MrAlvin/RAMPS_1.7/Schematics/images/1.7B3-top-aux.jpg

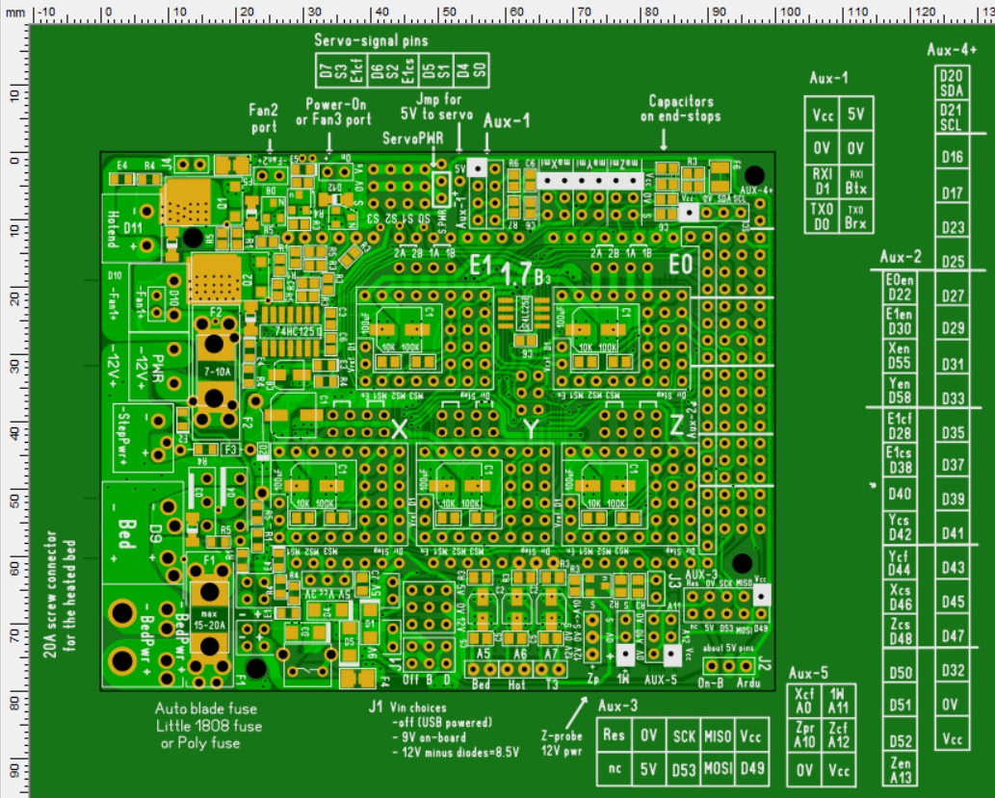
Schematics/images/1.7B3-top-aux.jpg
