MrAlvin/RAMPS_1.7/Schematics/pictures/extra_5V_on-board-power-800px.jpg

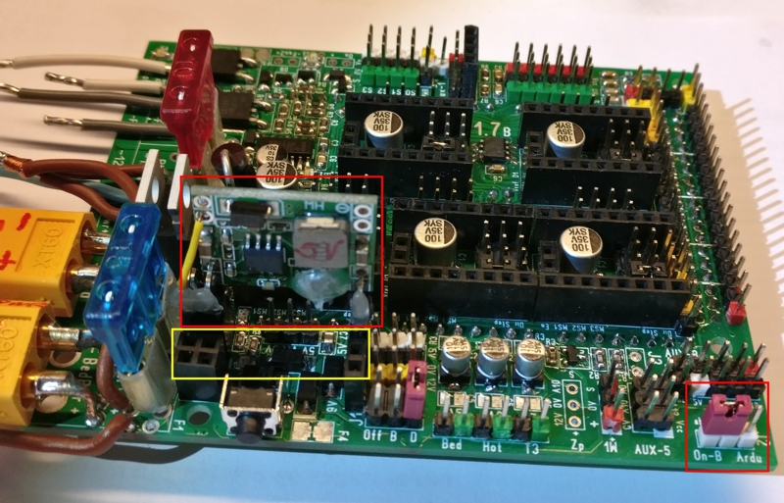
Schematics/pictures/extra_5V_on-board-power-800px.jpg
