MrAlvin/RAMPS_1.7/README.md

# RAMPS_1.7
An Arduino Shield for 3D printers

Documentation at: https://reprap.org/wiki/RAMPS_1.7<br>
Forum discussion at: https://reprap.org/forum/read.php?219,824661<br>
Firmware development at: https://github.com/MrAlvinTesting/Marlin/tree/bgfx-20x-R17-dev
