MrAlvin/RAMPS_1.7/Schematics/images/1.7B3-top-12V-options.jpg

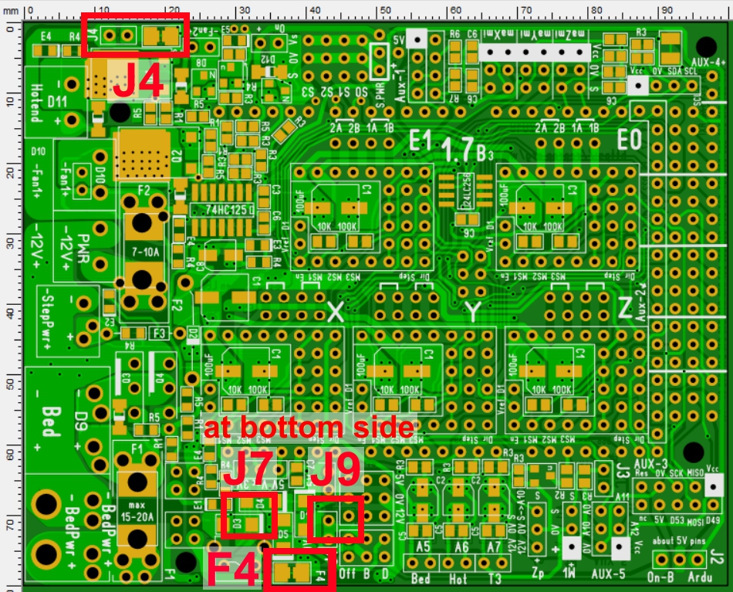
Schematics/images/1.7B3-top-12V-options.jpg
