MrAlvin/RAMPS_1.7/Schematics/images/1.7B3-top_extra_5V_on-board-power.jpg

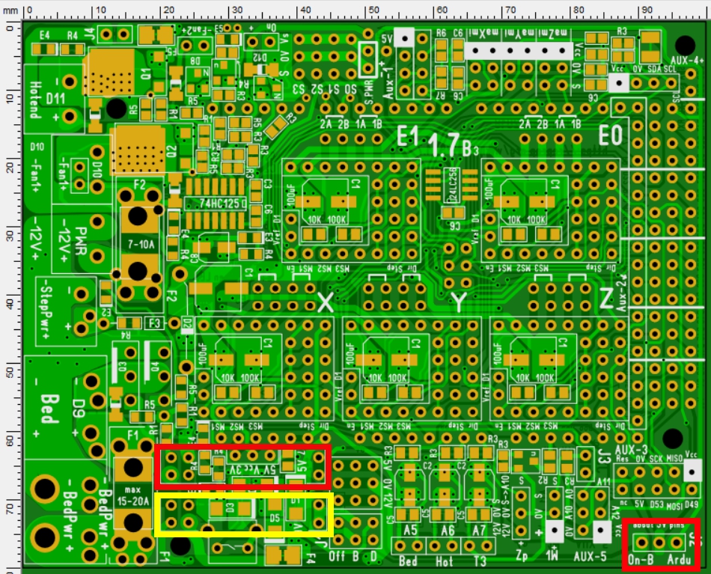
Schematics/images/1.7B3-top_extra_5V_on-board-power.jpg
