MrAlvin/RAMPS_1.7/Schematics/images/12V+5V-rails.jpg

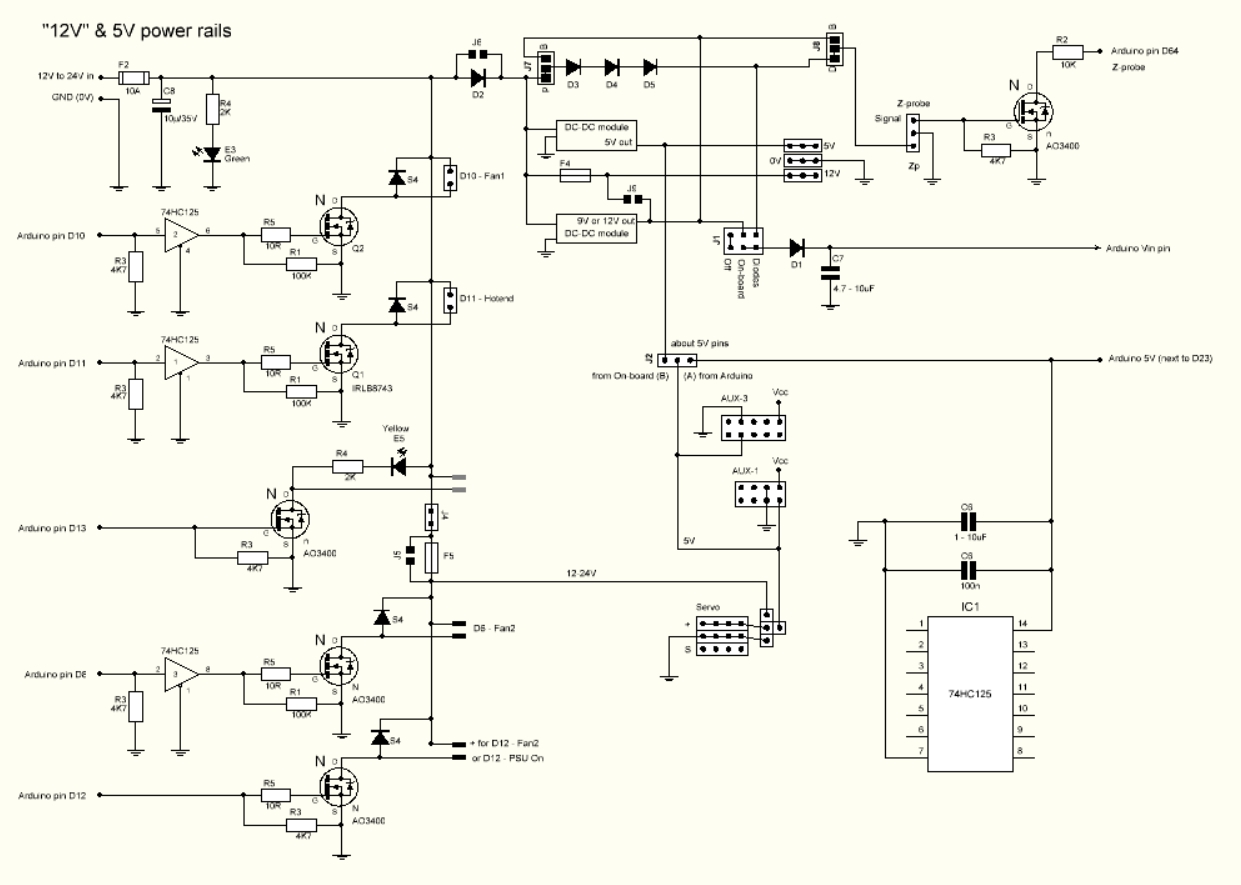
Schematics/images/12V+5V-rails.jpg
