MrAlvin/RAMPS_1.7/Schematics/images/extra_5V_on-board-power.jpg

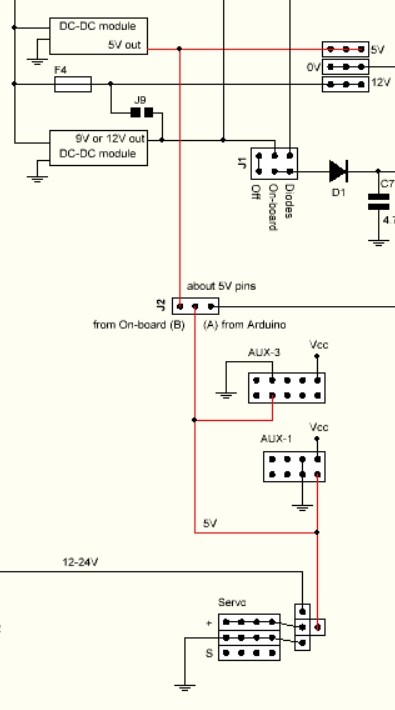
Schematics/images/extra_5V_on-board-power.jpg
