MrAlvin/RAMPS_1.7/Schematics/images/Heated_bed.jpg

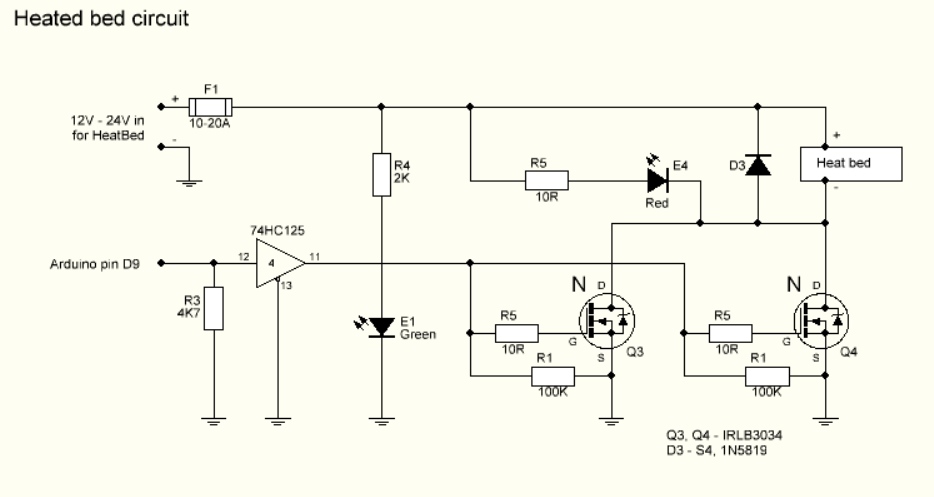
Schematics/images/Heated_bed.jpg
