MrAlvin/RAMPS_1.7/Schematics/pictures/mp1584_dc-dc_regulator.jpg

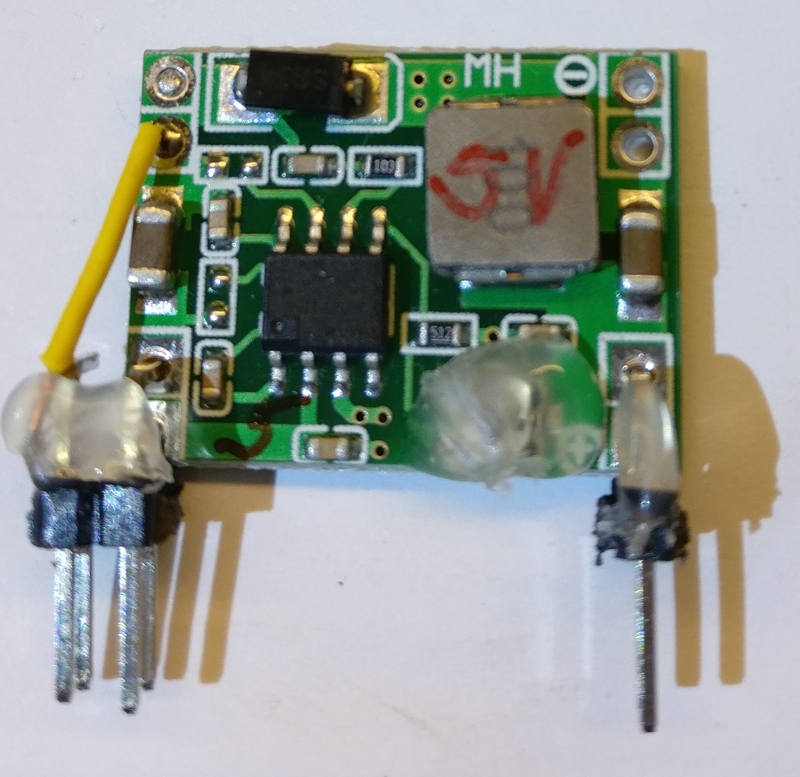
Schematics/pictures/mp1584_dc-dc_regulator.jpg
