MrAlvin/RAMPS_1.7/Schematics/images/24V operation with 12V options.jpg

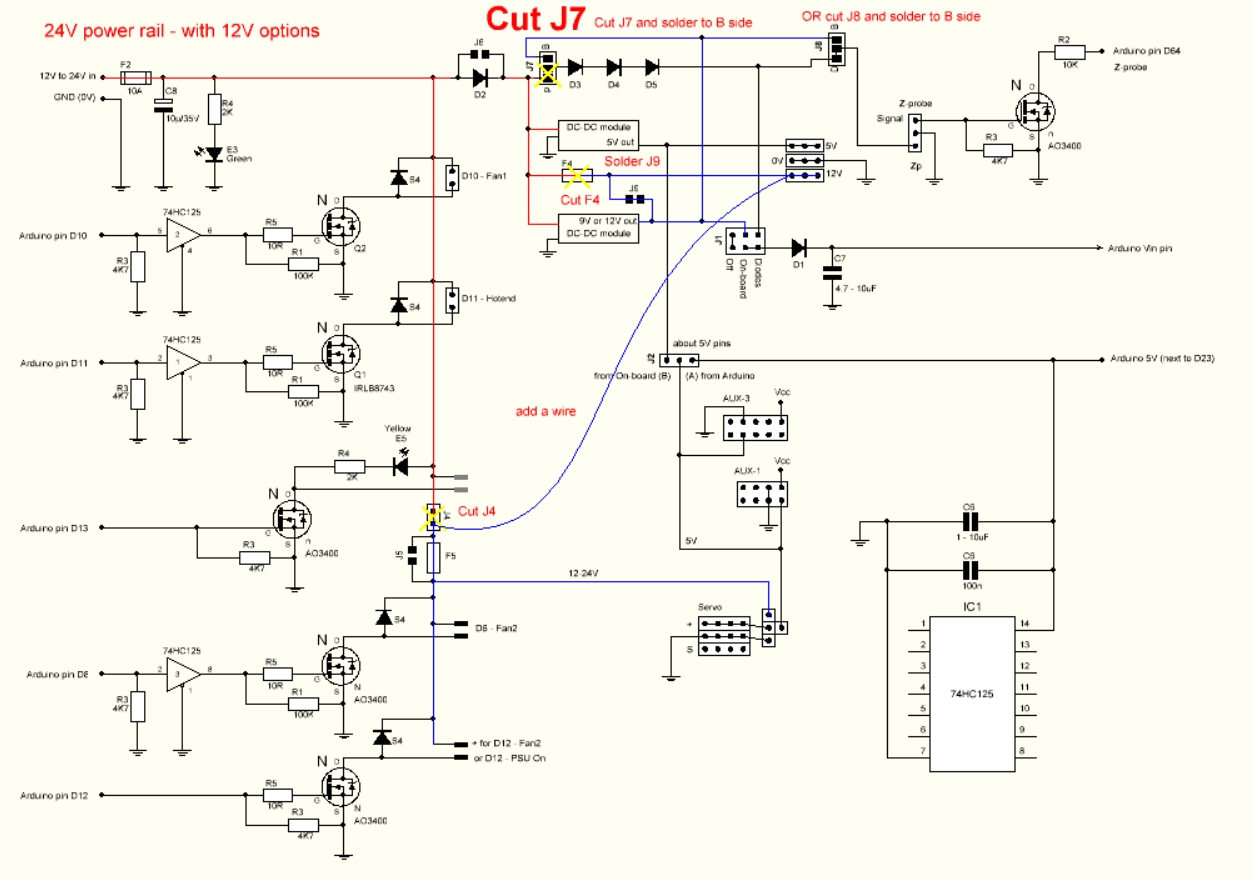
Schematics/images/24V operation with 12V options.jpg
