MrAlvin/RAMPS_1.7/Schematics/images/24V operation.jpg

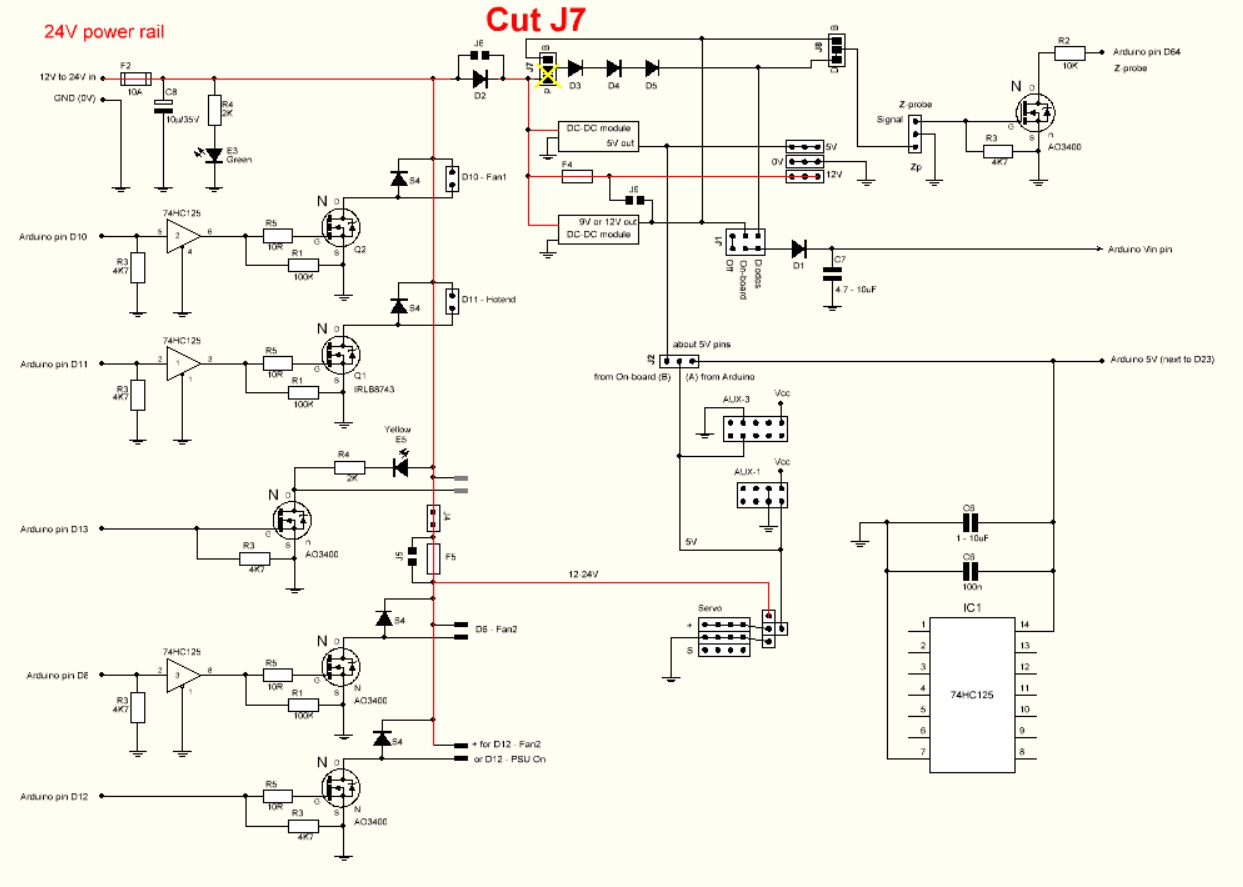
Schematics/images/24V operation.jpg
