MrAlvin/RAMPS_1.7/(threads)

Thread 1 (2018-09-16):

DXF files?

npgoalkeeper, 2018-09-16:
I really want to make another version of this with integrated TMC2130's and multiple TMC4361A's with an SPI encoder input for closed loop stepping.

MrAlvin, 2018-09-16:
Okay. What is an TMC4361A?  And how would it be connected to this Arduino Shield?

npgoalkeeper, 2018-09-16:
I want a DXF file so I have an outline to work with to make this shield, and the program I use you can only import .svg or .dxf files for board outlines and footprints.. The shield will also feature an LCD connector. Technically, the IC can be used to retrofit any motor driver, so the board should still be compatible with the DRV8825's and the A4988 and any other 3.3V or 5V driver.

MrAlvin, 2018-09-17:
I see. That does indeed sound very interesting. Unfortunately the program I work with, can only export gerber files or pictures.
Using a picture, was the way I moved from the RAMPS 1.4 design, to this RAMPS 1.7 design, as I am using a different PCB design program.

npgoalkeeper, 2018-09-17:
Alright. I'll figure it out :) I'll just wait until the final version is released in order to make my shield. Thanks.

MrAlvin, 2018-09-18:
hmmm.... good question.

The max size is 100 x 100 mm, and on one side, this max was reached on day one. And it seems that from time to time, I add a few millimeters, to accommodate the latest discovery/needed-adjustment/better design-idea.

I would like to re-design the entire mosfet area, as there are a few components that are with a rather tight fit.  But this would be a lot of work, so for now, I just leave it be.

 Either way; so far I seem to have made small adjustments about every week or so.

The four main influences to cause adjustments have so far been:

- because things look good on paper, does not mean that it feels right when you have the thing in your hands ..... and need to plug stuff in.  There may be room on paper, but it would simply be more smooth if this or that small adjustment was made.

- a design decision, made when things were first designed, may turn out to be better, if adjusted slightly, when I give it a second or third overhaul, or look deeper into details.

- making the Marlin firmware work.  As I have needed to dig in deeper under the hood of Marlin, I discover new things.
Like, this week, I have for instance made adjustments so it would be much easier to also use the shield with the Re-ARM MCU board.

- I have been working on adding functionality to the LCD board. Mainly so the entire LCD and buttons section can be controlled via I2C or SPI I/O-expanders. But this work has spun up more ideas, like;
-- what if  an ESP-01 connector could be added to the main board?
-- and what if temperature sensors could be made to be able to handle volt abuse, like; 24V applied to either of the two wires to the temperature sensor to have no effect of the MCU. That would be a rather nice addition.
--servo pin 3 and 4 have dual functionality. What if the re-arranging of the mosfet-section, also caused there to be room for easy jumper connectors to move some functionality to freed pins on aux-4, now that the LCD is being handled by I/O-expanders.
-- what if I/O-expanders, especially SPI I/O-expanders were added to some of the fewer-pin-count 32-bit processors, would it then be possible to use 4-5 dollar MCU's to control the board. And would this cause me want to make adjustments to the RAMPS 1.7 board?
-- what if a universal I/O-expander, like an atmega88, were added to the mix, would it then be feasible to monitor voltages and fuses?

Yes, stuff like that seems to creep in, and cause the board to sometimes grow a little, in the one direction where there is still room to grow.

What is however set in stone, is:
- the Arduino pins layout.
- the correlation of placement between Aux-3 and Aux-4.  The most common LCD adapter, uses both these ports, and it MUST be possible to use that adapter board with a RAMPS-named board.
- the stepper drivers are not going to move....... Unless - the mosfet-section gets a makeover. As it would be nice to move the X,Y,Z stepper section about 1mm away from the Aux-2 / Aux-4 section.

So, does this answer you question?

Are there any particular connectors that you are more interested in, to not move?

npgoalkeeper, 2018-09-18:
No. That's it. Thanks. I'd rather this shield not change and mine to change a LOT so that you're not restricted. If you had to accommodate for everybody, then nothing would get done. I'll start doing BOM, then I'll do PCB design later down the line when you have the final layout. If you do change the layout in the future after I made my shield, then I'll change the layout of mine. I really do believe in the philosophy of a modular system with bits that can be changed. I got so triggered when apple started soldering their RAM and SSD's straight to the board.

npgoalkeeper, 2018-09-18:
Oh btw the free (so professional) program that I use is cloud based, and you can oversee my project if you so desire:
here:https://easyeda.com/npgoalkeeper/ramps1-7
It will feature an LCD connector, the stuff I said earlier, but no connector for stepsticks, I want to be able to use dcstep which has has an output that is not broken out. Also, no current scaling via potentiometer,  only through firmware via PWM (I'm using a DAC, digipot is too expensive).

Also, I won't  close this issue. I clearly keep changing my mind.

npgoalkeeper, 2018-09-19:
For the regulator, should I add a Ti PMIC along with a flyback converter controller and n-ch mosfets? The output would be able to change from 5v to 3.3v with a very small tolerance (around 3 percent of I recall correctly). Otherwise, I will just stick with the lm2576 linear regulator.
