MrAlvin/RAMPS_1.7/Schematics/pdf/RAMPS_1.7_24V-operation.pdf

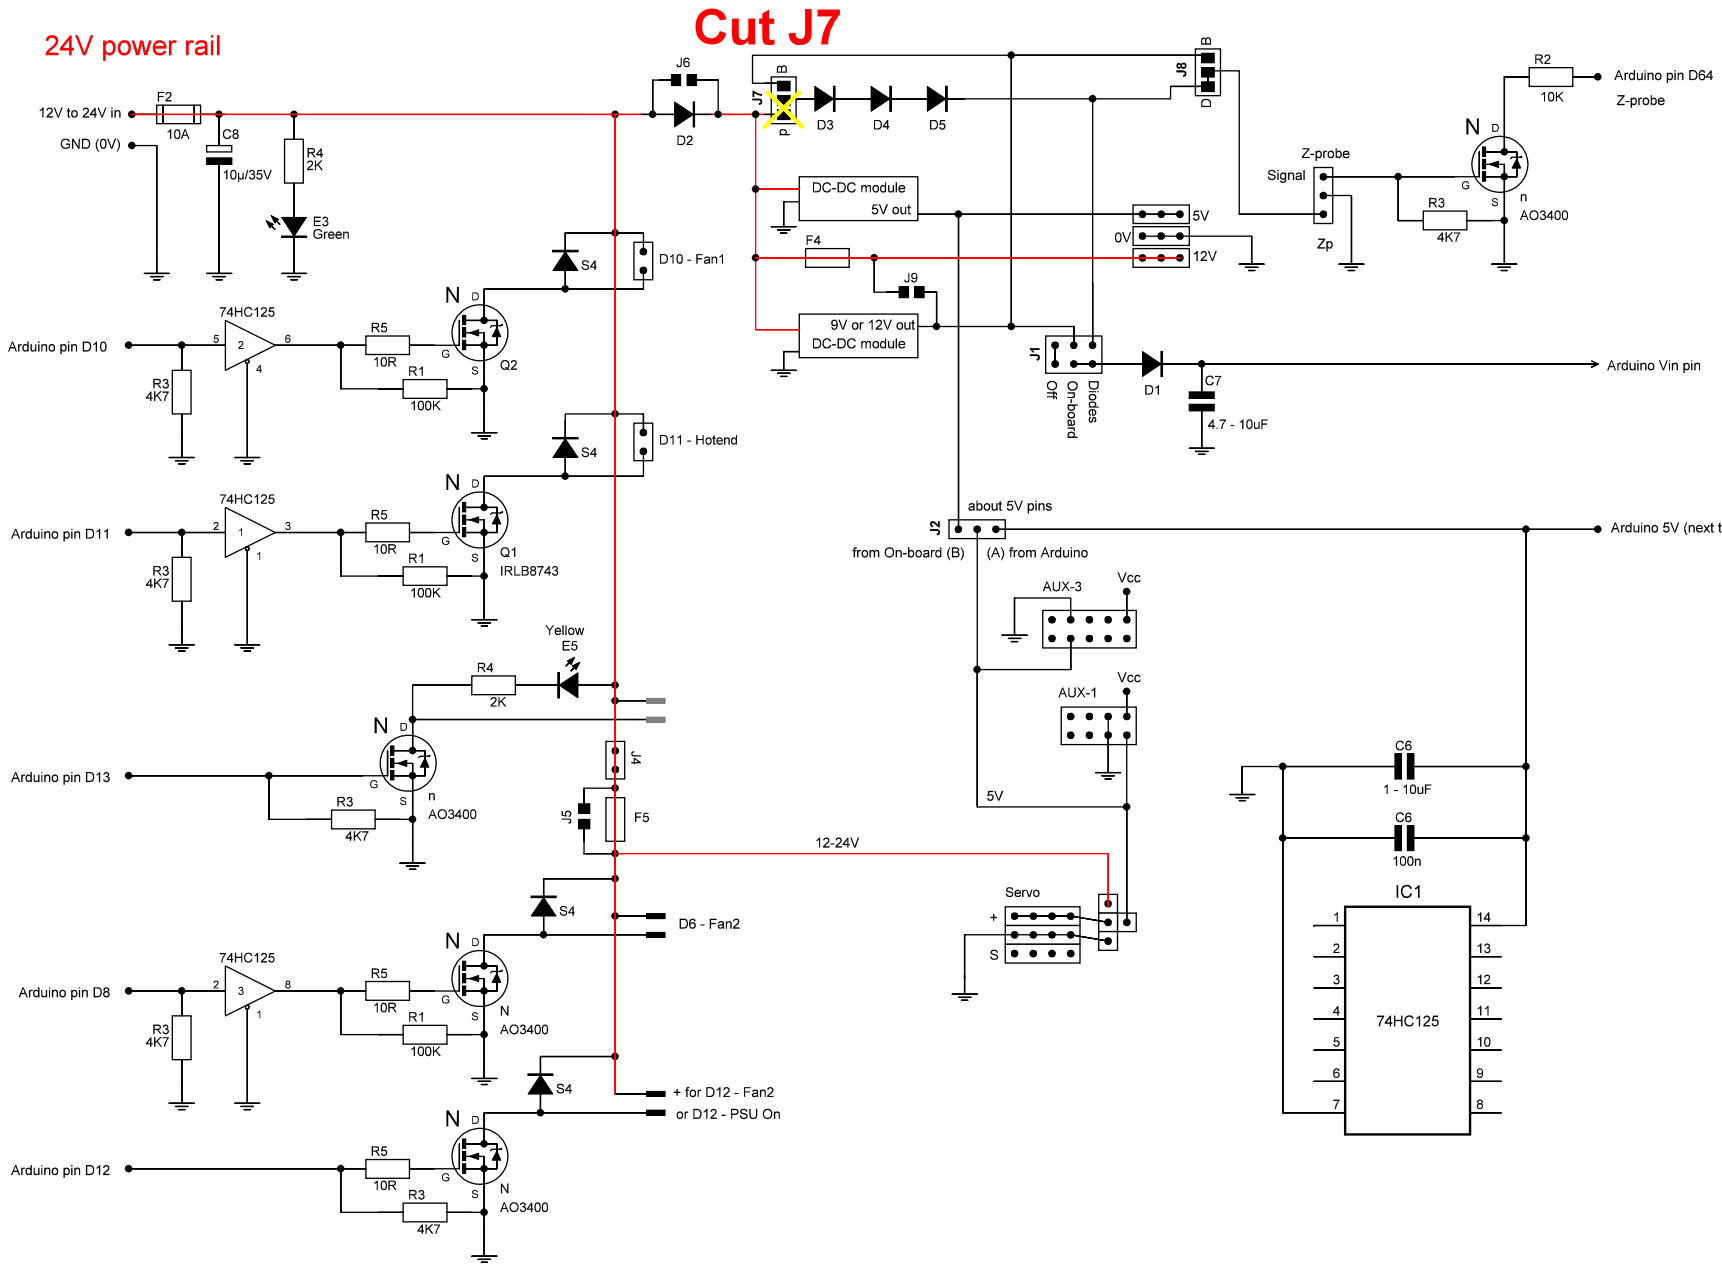
[picture p11: page 1]
