MrAlvin/RAMPS_1.7/Schematics/pdf/RAMPS_1.7_24V-operation_with-12V-options.pdf

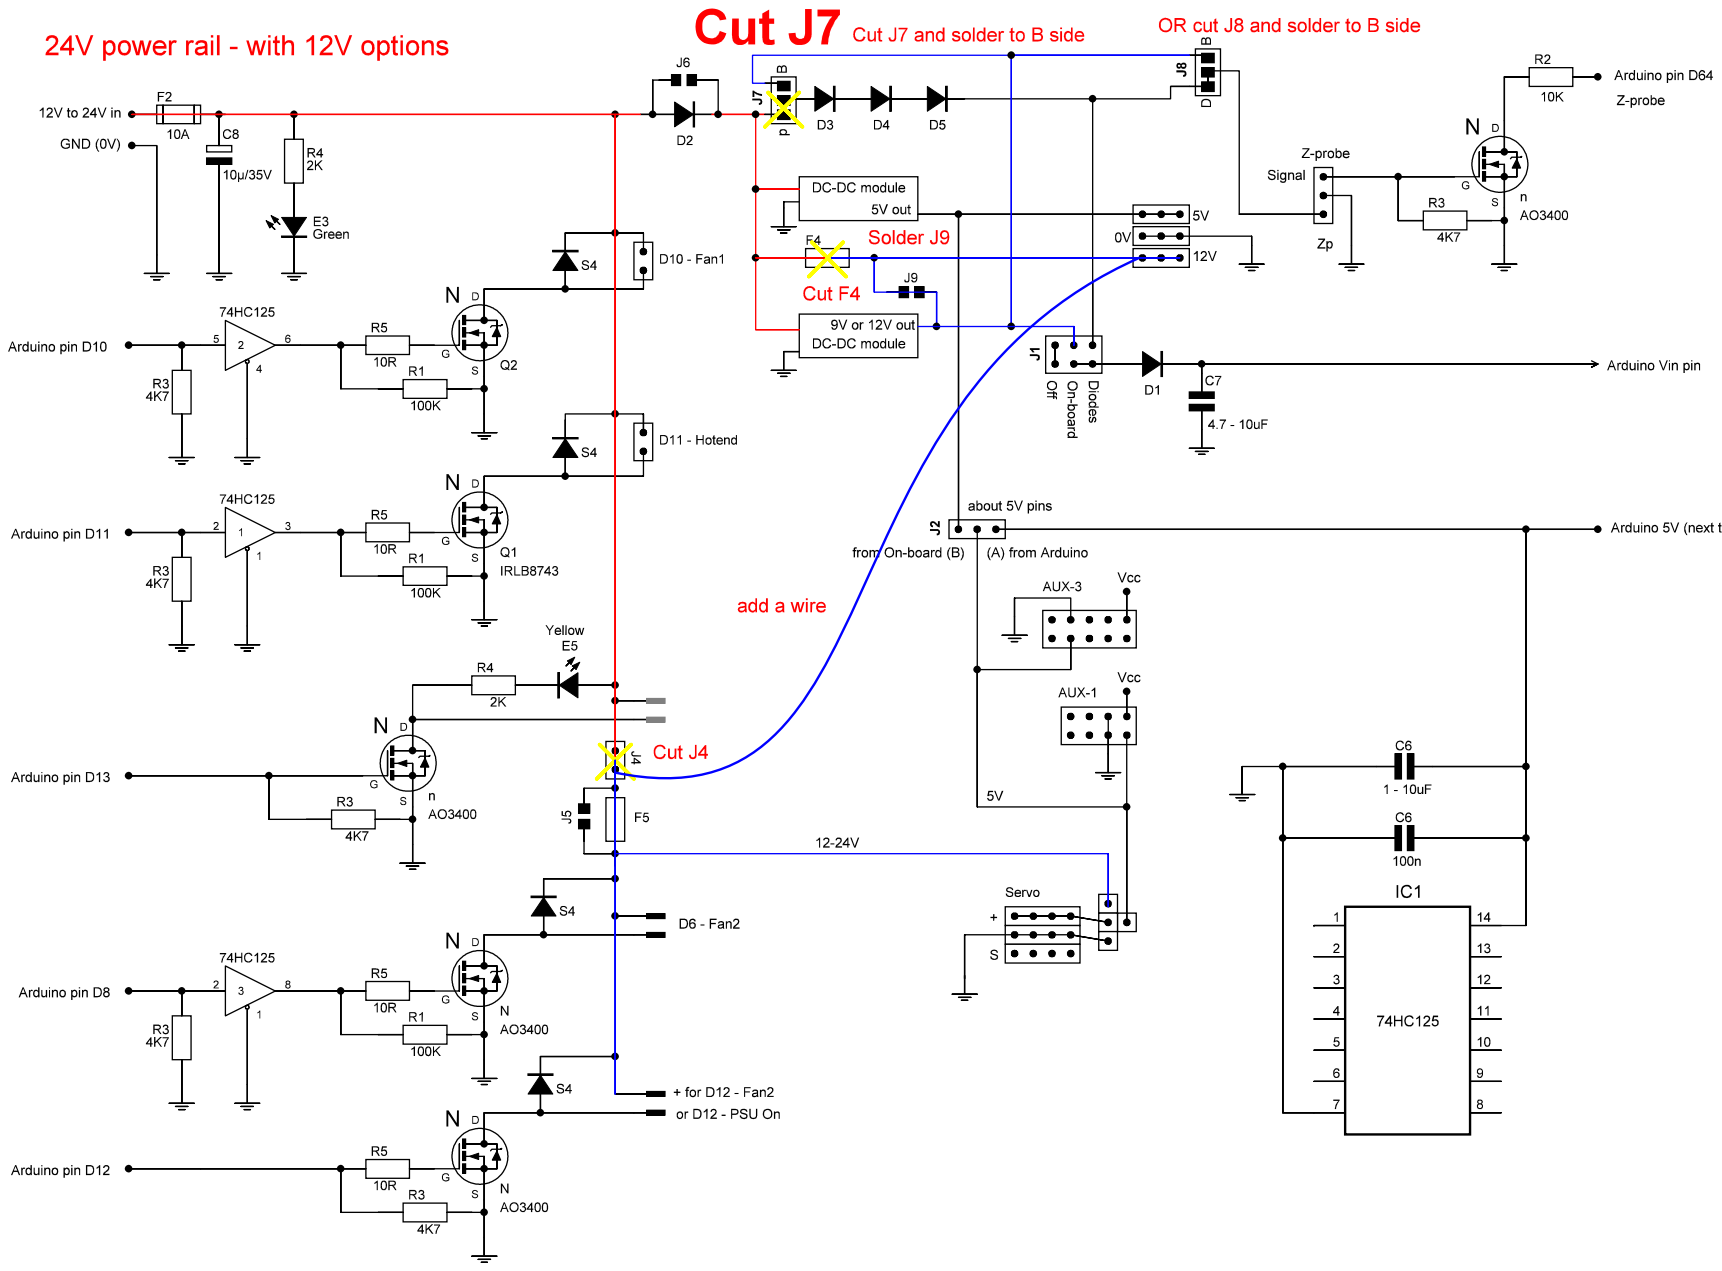
[picture p12: page 1]
