MrAlvin/RAMPS_1.7/Schematics/pdf/RAMPS_1.7_12V+5V_rails.pdf

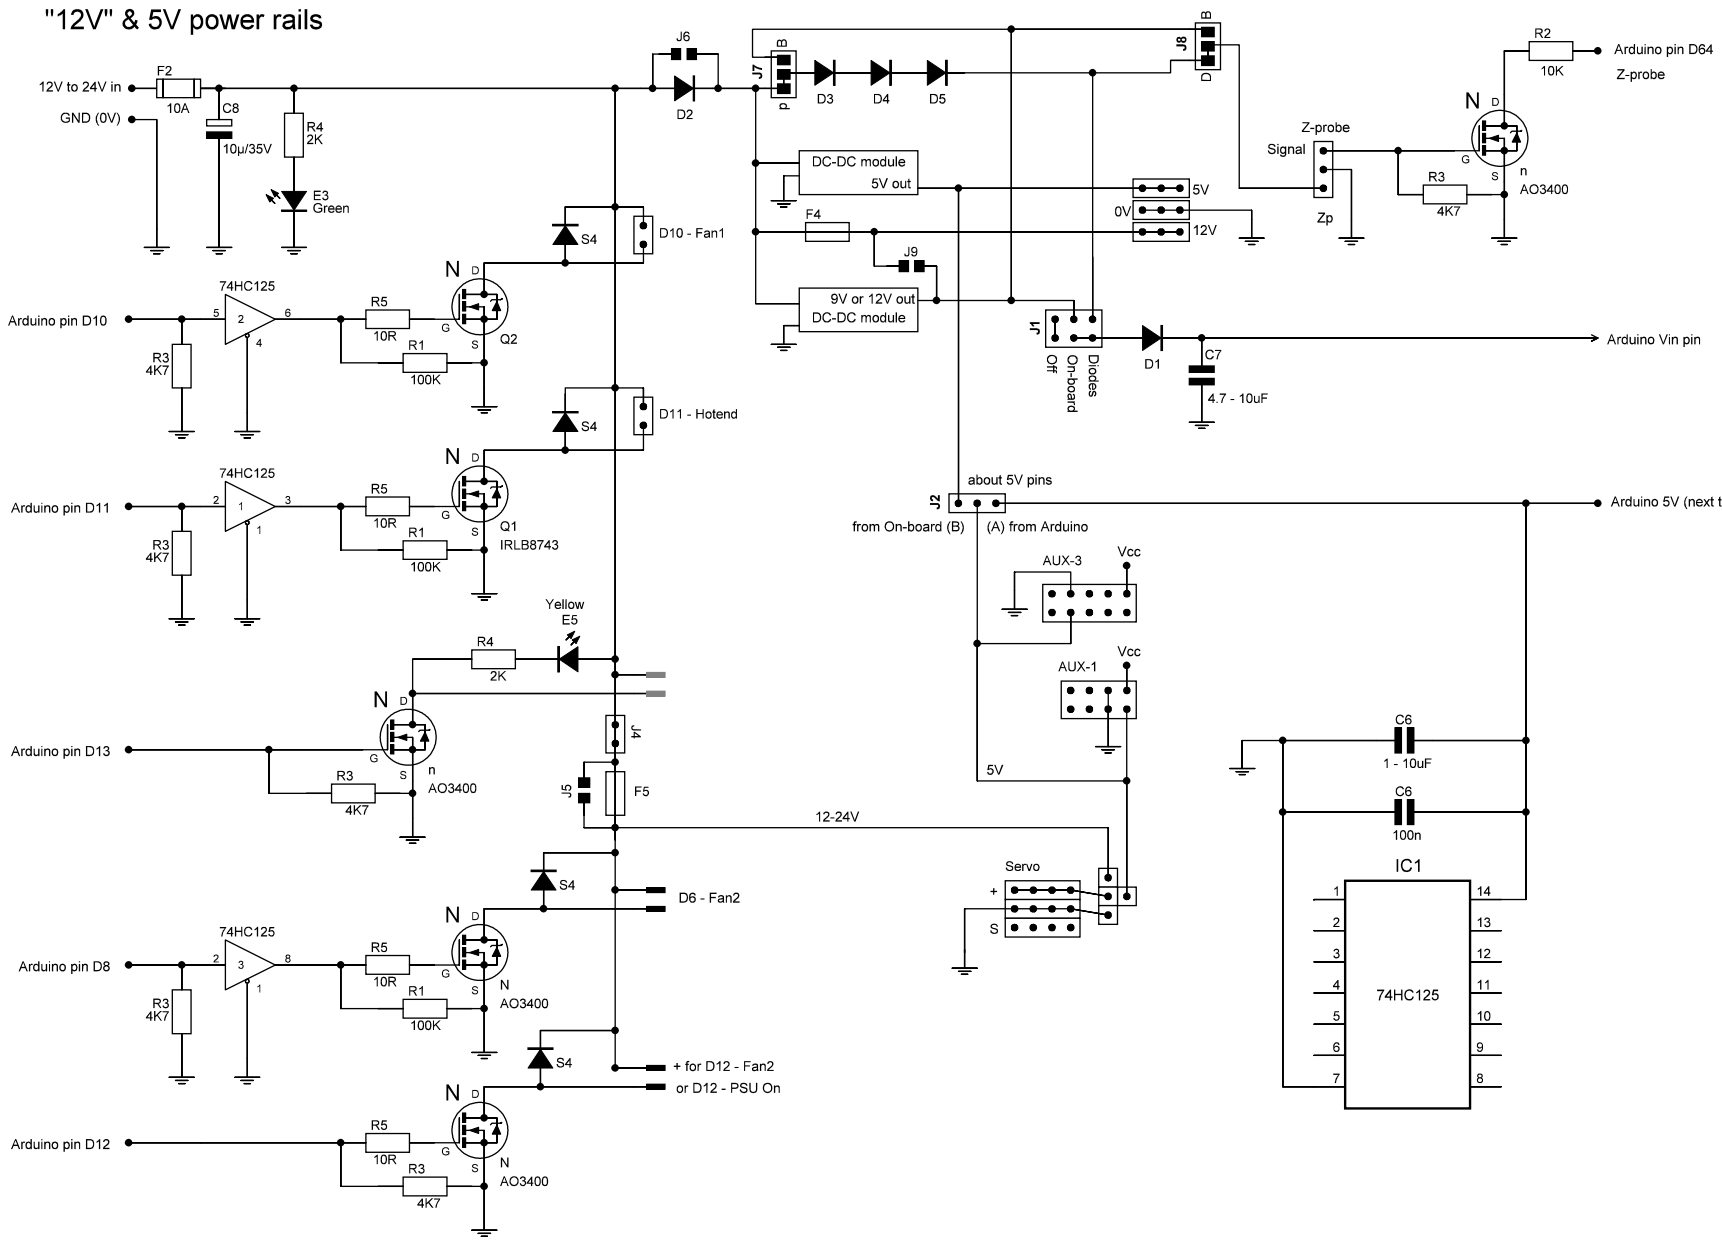
[picture p13: page 1]
