MrAlvin/RAMPS_1.7/Schematics/pdf/RAMPS_1.7_extra_5V_on-board_rail_marked.pdf

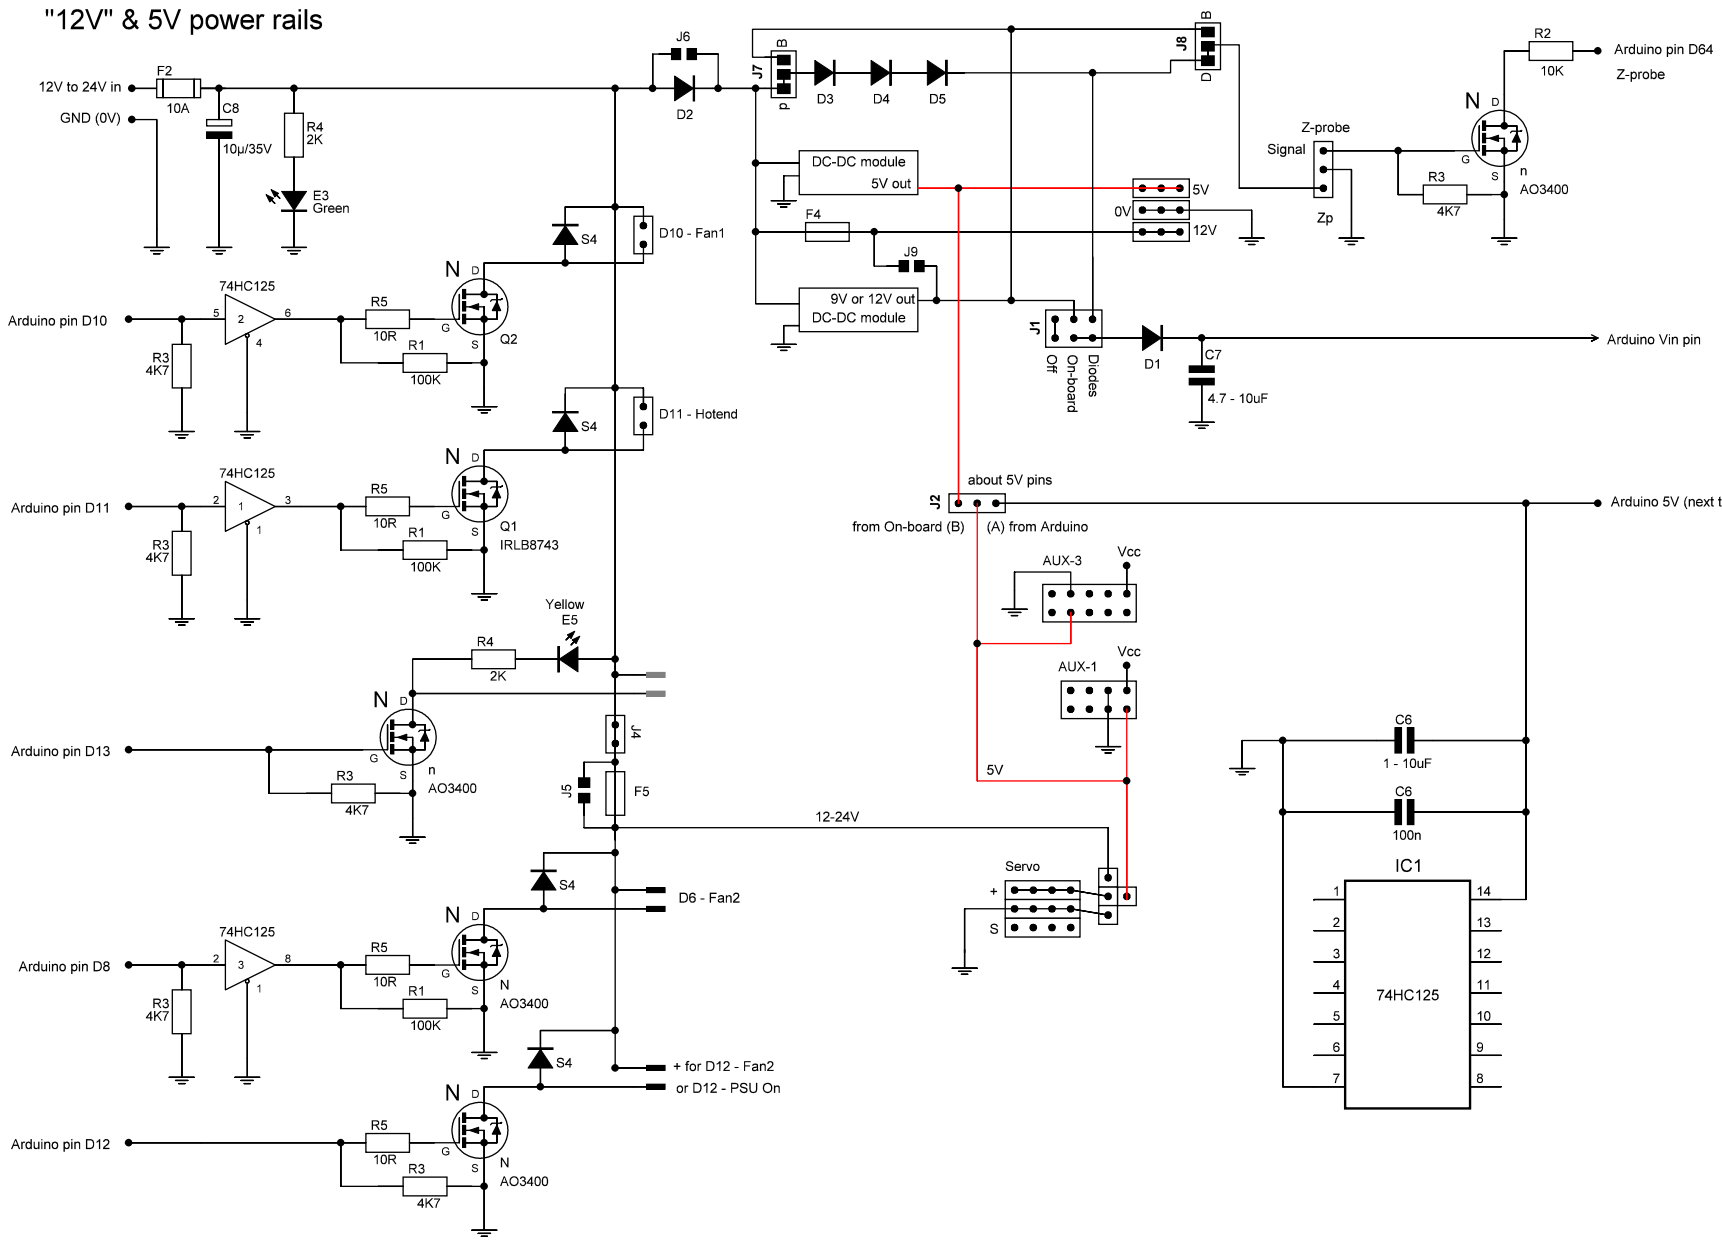
[picture p14: page 1]
