MrAlvin/RAMPS_1.7/Schematics/pdf/RAMPS_1.7_heated_bed.pdf

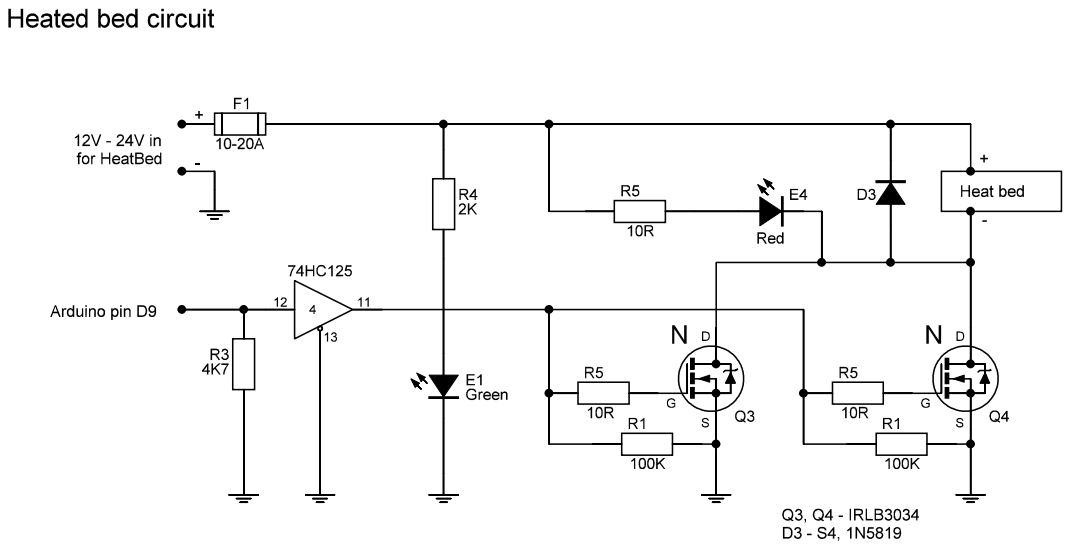
[picture p15: page 1]
