MrAlvin/RAMPS_1.7/(list of files, drawings)

Other design files:
PCB files/LCD01/2018 RAMPS 1.7 - LCD01 3-5V adapter.lay6
PCB files/LCD03/RAMPS17-LCD03.lay6
