MrAlvin/RAMPS_1.7/(commit log)

2018-08-15 added heat-bed to schematics
2018-08-15 added arduino test sketches
2018-08-20 added "12V" + 5V rails schematics and images
2018-08-20 24V on main rail, and how to add 12V options
2018-08-20 added a 5V board illustration
2018-08-28 added LCD universal bi-directional 3V<->5V adapter for aux-3 and aux-4
    [2018 RAMPS 1.7 - LCD01 3-5V adapter.lay6]
2018-09-01 Updated the link to the Marlin Firmware RAMPS 1.7 development version
2018-09-06 Updated SD_listfiles. Changed name of I2C eeprom test sketch.
2018-09-08 Fixed errors. Added LED and buzzer limiter.
    [2018 RAMPS 1.7 - LCD01 3-5V adapter.lay6]
2019-01-18 TMC2130 testing via Arduino library by teemuatlut
2019-03-04 Testing board revision C (RAMPS 1.7C)
2019-03-05 added LCD-03 PCB files
    [RAMPS17-LCD03.lay6]
